vojtapl/esp32-air-quality-monitor-epd/resources/img_graph.jpg

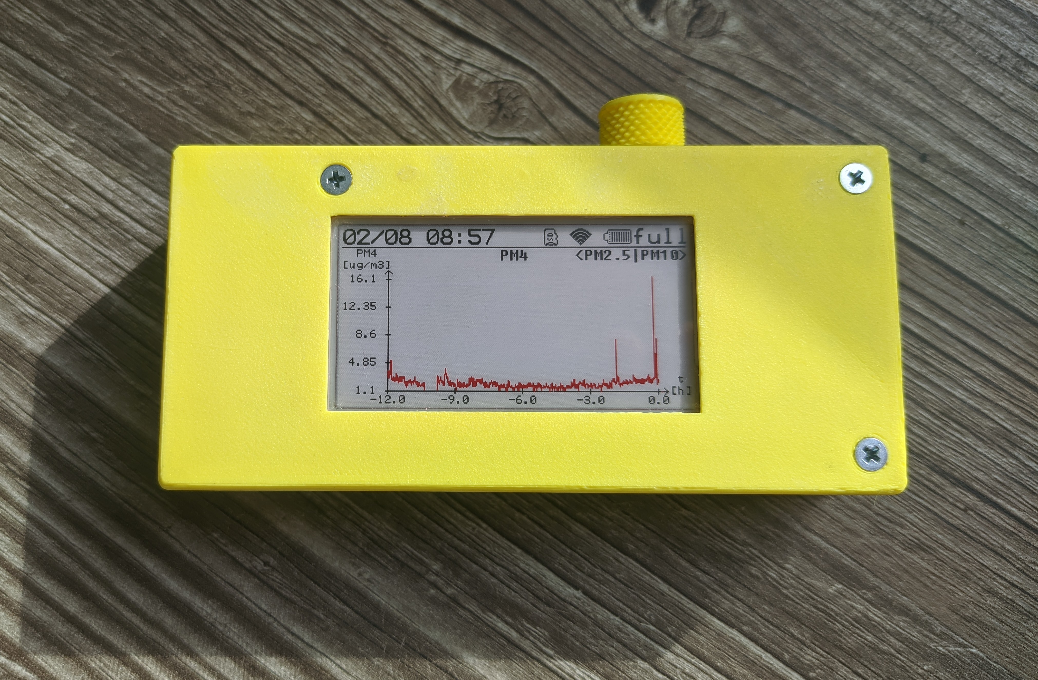
resources/img_graph.jpg
