vojtapl/esp32-air-quality-monitor-epd/hardware/pcb/sen66-air-quality-meter.kicad_pcb

## KiCad design hardware/pcb/sen66-air-quality-meter.kicad_pcb (2025-08-02)

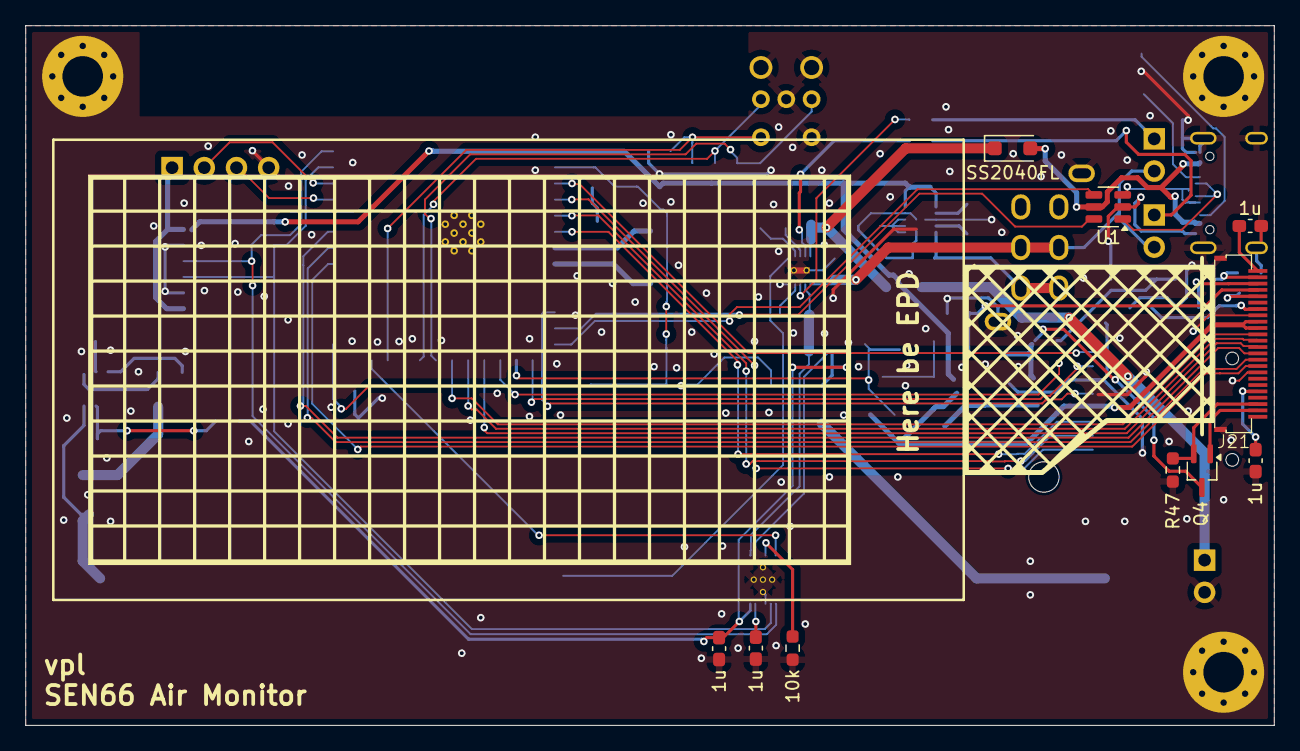
[picture p7: board sen66-air-quality-meter.kicad_pcb from above]

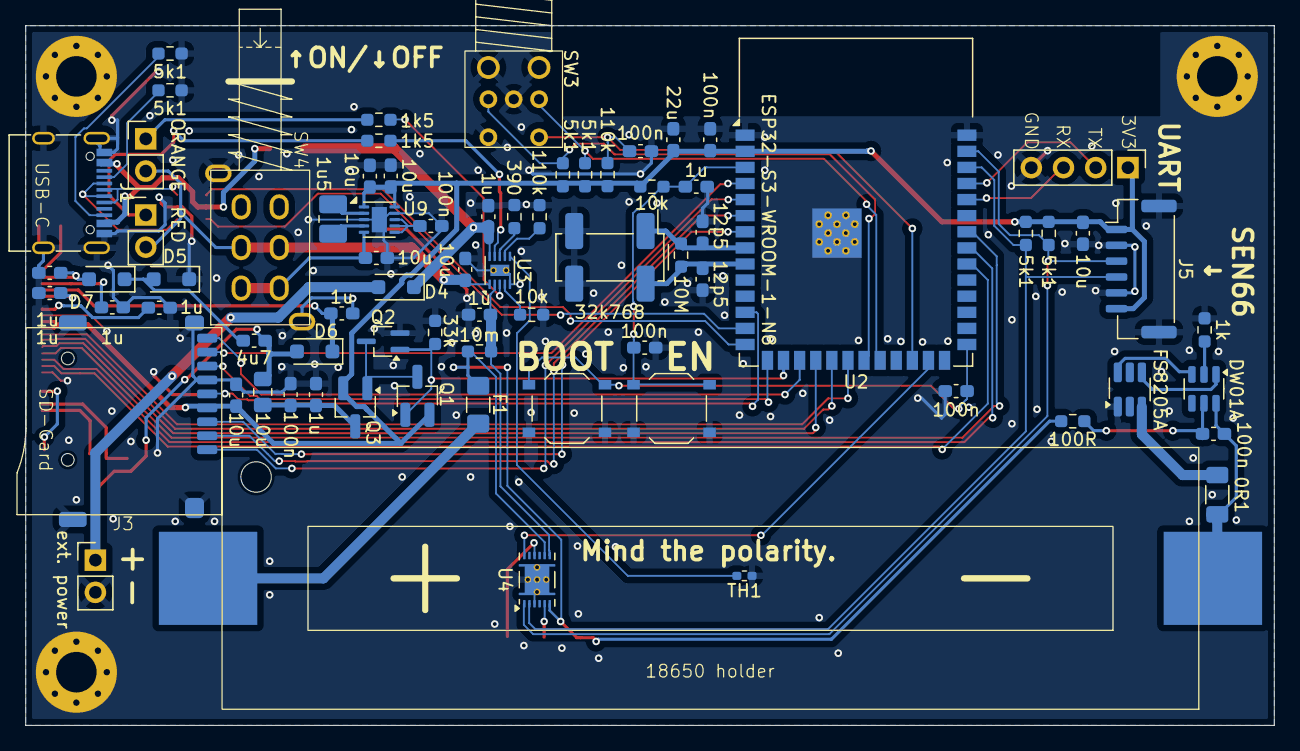
[picture p8: board sen66-air-quality-meter.kicad_pcb from below]

Board: 2 copper layers, 98.5 x 55.2 mm, 88 parts (75 on the bottom side), 74 nets.

Parts:
BT1: 18650 battery holder; BH-18650-B1BA002
C1, C2, C6, C8, C15, C26, C28: 100n; C_0603_1608Metric_Pad1.08x0.95mm_HandSolder
C3, C7, C10, C14, C16, C17, C19, C20, C21, C22, C23, C24, C25: 1u; C_0603_1608Metric_Pad1.08x0.95mm_HandSolder
C4, C5: 12p5; C_0603_1608Metric_Pad1.08x0.95mm_HandSolder
C9: 22u; C_0603_1608Metric_Pad1.08x0.95mm_HandSolder
C11, C12, C13, C27, C29, C30: 10u; C_0603_1608Metric_Pad1.08x0.95mm_HandSolder
C18: 4u7; C_0603_1608Metric_Pad1.08x0.95mm_HandSolder
D1: RED; PinHeader_1x02_P2.54mm_Vertical
D2: ORANGE; PinHeader_1x02_P2.54mm_Vertical
D3, D4, D5, D6, D7: SS2040FL; D_SOD-123F
F1: Polyfuse 2A; Fuse_1206_3216Metric_Pad1.42x1.75mm_HandSolder
H2, H3, H4: MountingHole_Pad; MountingHole_3.2mm_M3_Pad_Via
J1: USB-C female, 16P; USB_C_Receptacle_G-Switch_GT-USB-7010ASV
J2: ext. power; PinHeader_1x02_P2.54mm_Vertical
J3: SHOU HAN TF PUSH
J4: UART; PinHeader_1x04_P2.54mm_Vertical
J5: WAFER-GH1.25-6PLB; JST_GH_BM06B-GHS-TBT_1x06-1MP_P1.25mm_Vertical
J21: FH34SRJ24S; FH34SRJ-24S-0.5SH(50)
L1: 10u; L_0805_2012Metric_Pad1.15x1.40mm_HandSolder
L2: 1u5; L_1008_2520Metric_Pad1.43x2.20mm_HandSolder
Q1, Q3: AP2305; SOT-23_Handsoldering
Q2, Q4: SI1308EDL; SOT-323_SC-70_Handsoldering
R1, R2, R4, R5, R7, R8: 5k1; R_0603_1608Metric_Pad0.98x0.95mm_HandSolder
R3, R9, R16: 10k; R_0603_1608Metric_Pad0.98x0.95mm_HandSolder
R6, R11: 110k; R_0603_1608Metric_Pad0.98x0.95mm_HandSolder
R10: 10M; R_0603_1608Metric_Pad0.98x0.95mm_HandSolder
R12, R13: 1k5; R_0603_1608Metric_Pad0.98x0.95mm_HandSolder
R14: 390; R_0603_1608Metric_Pad0.98x0.95mm_HandSolder
R15: 33k; R_0603_1608Metric_Pad0.98x0.95mm_HandSolder
R17: 10m; R_0603_1608Metric_Pad0.98x0.95mm_HandSolder
R18: 1k; R_0603_1608Metric_Pad0.98x0.95mm_HandSolder
R19: R47; R_0603_1608Metric_Pad0.98x0.95mm_HandSolder
R20: 0R1; R_1206_3216Metric_Pad1.30x1.75mm_HandSolder
R21: 100R; R_0603_1608Metric_Pad0.98x0.95mm_HandSolder
SW1, SW2: TS-1187A; SW_Push_1P1T_XKB_TS-1187A
SW3: ED08905M; ED08905M-FE13C7.3-C10-2053
SW4: XKBS22E05-Z
TH1: NTCG104BH103HT1; R_0402_1005Metric_Pad0.72x0.64mm_HandSolder
U1: USBLC6-2SC6; SOT-23-6
U2: ESP32-S3-WROOM-1-N8; ESP32-S3-WROOM-1
U3: BQ25185; Texas_DLH0010A_WSON-10-1EP_2.2x2mm_P0.4mm_EP0.9x1.5mm_Therm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
U4: BQ27441DRZR-G1A; Texas_S-PDSO-N12
U6: DW01A; SOT-23-6
U7: FS8205A; SOT-23-6_Handsoldering
U9: TPS63031DSK; WSON-10-1EP_2.5x2.5mm_P0.5mm_EP1.2x2mm
Y1: 32k768; Crystal_SMD_SeikoEpson_MC306-4Pin_8.0x3.2mm_HandSoldering

Connections:
+3V3: C8.1, C9.1, C12.1, C13.1, C29.1, C30.1, J3.4 (VDD), J4.1, J5.1, J5.6, J21.15, J21.16, Q1.2 (S), Q3.2 (S), R1.1, R2.1, R3.1, R6.1, R7.1, R8.1, U2.2 (3V3), U9.1 (VOUT), U9.10 (FB)
/BOOT_OPTION: C2.1, SW2.1, U2.27 (IO0)
/BUSY: J21.9, U2.32 (IO39)
/D/C: J21.11, U2.34 (IO41)
/EN: C1.1, C3.2, R3.2, SW1.1, U2.3 (EN)
/EPD_POWER: Q1.1 (G), Q2.1 (G), R15.1, U2.16 (IO46)
/RES: J21.10, U2.33 (IO40)
/RX: J4.3, U2.36 (RXD0)
/SCL: J5.4, R8.2, U2.38 (IO2), U4.2 (SCL)
/SD CLK: J3.5 (CLK), U2.12 (IO8)
/SD CMD: J3.3 (CMD), U2.7 (IO7)
/SD D0: J3.7 (DAT0), U2.15 (IO3)
/SD D1: J3.8 (DAT1), U2.4 (IO4)
/SD D2: J3.1 (DAT2), U2.5 (IO5)
/SD D3: J3.2 (DAT3/CD), U2.6 (IO6)
/SD DET: J3.9 (DET), U2.17 (IO9)
/SDA: J5.3, R7.2, U2.39 (IO1), U4.1 (SDA)
/SPI_MOSI: J21.14, U2.20 (IO12)
/SPI_SCLK: J21.13, U2.19 (IO11)
/TX: J4.2, U2.37 (TXD0)
/USB 5V: D3.2 (A), J1.A4 (VBUS), J1.A9 (VBUS), J1.B4 (VBUS), J1.B9 (VBUS), U1.5 (VBUS)
/USB D+: U1.4 (I/O2), U2.14 (USB_D+)
/USB D-: U1.6 (I/O1), U2.13 (USB_D-)
/V_{BAT}: C10.1, R17.2, U3.2 (BAT), U4.7 (SRN)
/bat low alarm: U2.25 (IO48), U4.12 (GPOUT)
/encoder A: R2.2, SW3.A, U2.21 (IO13)
/encoder B: R1.2, SW3.B, U2.22 (IO14)
/encoder button: C6.2, R6.2, SW3.S1, U2.24 (IO47)
/~SPI_EPD_CS: J21.12, U2.18 (IO10)
GND: C1.2, C2.2, C3.1, C4.2, C5.2, C6.1, C7.2, C8.2, C9.2, C10.2, C11.2, C12.2, C13.2, C14.2, C15.2, C16.2, C17.2, C19.2, C20.2, C21.2, C22.2, C23.2, C24.2, C25.2, C27.2, C28.2, C29.2, C30.2, D5.1 (K), H2.1, H3.1, H4.1, J1.A1 (GND), J1.A12 (GND), J1.B1 (GND), J1.B12 (GND), J1.S1 (SHIELD), J2.2, J3.6 (VSS), J3.10 (SHIELD), J4.4, J5.2, J5.5, J5.MP (MountPin), J21.8, J21.17, J21.MP (MountPin), Q2.2 (S), R4.2, R5.2, R9.1, R11.2, R14.2, R15.2, R16.1, R18.2, R19.2, SW1.2, SW2.2, SW3.C, SW3.MP, SW3.S2, SW4.MP, TH1.1, U1.2 (GND), U2.1 (GND), U2.40 (GND), U2.41 (GND), U3.5 (GND), U3.11 (Thermal_Pad), U4.3 (V_{SS}), U4.13 (PAD), U7.1 (S1), U9.3 (PGND), U9.9 (GND), U9.11 (PGND), Y1.2, Y1.3
unnamed: BT1.1 (+), F1.2
unnamed: BT1.2 (-), C26.2, R20.2, U6.6 (GND)
unnamed: D1.1 (K), R12.1
unnamed: D2.1 (K), R13.1
unnamed: C7.1, D3.1 (K), D4.1 (K), U3.10 (IN)
unnamed: D4.2 (A), J2.1
unnamed: C18.2, D5.2 (A), D7.1 (K)
unnamed: C18.1, D6.2 (A), L1.2, Q4.3 (D)
unnamed: C19.1, D6.1 (K), J21.21
unnamed: C20.1, D7.2 (A), J21.23
unnamed: J1.A5 (CC1), R4.1
unnamed: J1.B5 (CC2), R5.1
unnamed: J1.A6 (D+), J1.B6 (D+), U1.3 (I/O2)
unnamed: J1.A7 (D-), J1.B7 (D-), U1.1 (I/O1)
unnamed: J21.2, Q4.1 (G)
unnamed: J21.3, Q4.2 (S), R19.1
unnamed: C21.1, J21.5
unnamed: C22.1, J21.18
unnamed: C23.1, J21.20
unnamed: C24.1, J21.22
unnamed: C25.1, J21.24
unnamed: Q1.3 (D), Q2.3 (D), Q3.1 (G)
unnamed: C15.1, C16.1, L1.1, Q3.3 (D)
unnamed: C4.1, R10.1, U2.8 (IO15), Y1.1
unnamed: C5.1, R10.2, U2.9 (IO16), Y1.4
unnamed: R11.1, U3.7 (ILIM/VSET)
unnamed: R14.1, U3.8 (I_{SET})
unnamed: R12.2, U3.9 (STAT1)
unnamed: R13.2, U3.3 (STAT2)
unnamed: TH1.2, U3.6 (TS/MR)
unnamed: R9.2, U3.4 (~CE)
unnamed: C17.1, F1.1, R17.1, R21.1, U4.6 (BAT), U4.8 (SRP)
unnamed: R16.2, U4.10 (BIN)
unnamed: C14.1, U4.5 (V_{DD})
unnamed: R18.1, U6.2 (CS)
unnamed: U6.3 (OC), U7.6 (G1)
unnamed: U6.1 (OD), U7.4 (G2)
unnamed: C26.1, R21.2, U6.5 (VCC)
unnamed: R20.1, U7.3 (S2)
unnamed: C28.1, U9.6 (EN), U9.7 (PS/SYNC), U9.8 (VINA)
unnamed: L2.2, U9.4 (L1)
unnamed: L2.1, U9.2 (L2)
unnamed: C27.1, SW4.3, SW4.6, U9.5 (VIN)
VBUS: C11.1, D1.2 (A), D2.2 (A), SW4.2, SW4.5, U3.1 (SYS)
