vojtapl/esp32-air-quality-monitor-epd/software/esp32/src/config.h

#pragma once

#define SERIAL_BAUDRATE 460800
#define I2C_CLOCK 100000

#define DATA_PATH "/data.csv"

#define BUF_SIZE 128 // measured once at 103 chars

#define BATTERY_INIT_CAPACITY_mAh 2000
#define BATTERY_NOMINAL_VOLTAGE_V 3.7f
#define BATTERY_TERMINAL_VOLTAGE_mV 3000 // TODO: check the value
#define BATTERY_TAPER_CURRENT_mA 81      // 10% of I_charge

#define BTN_PRESS_THRESHOLD_SHORT 50  // in ms
#define BTN_PRESS_THRESHOLD_LONG 1000 // in ms

#define UPDATE_PERIOD_EPD 300  // in s
#define UPDATE_PERIOD_SEN66 10 // in s

#ifdef NO_ERROR
#undef NO_ERROR
#endif
#define NO_ERROR 0

#define LONG_PRESS 2000

#define THRESH_BADNESS_1_PM1 35
#define THRESH_BADNESS_2_PM1 55

#define THRESH_BADNESS_1_PM2P5 35
#define THRESH_BADNESS_2_PM2P5 55

#define THRESH_BADNESS_1_PM4 35
#define THRESH_BADNESS_2_PM4 55

#define THRESH_BADNESS_1_PM10 155
#define THRESH_BADNESS_2_PM10 255

#define THRESH_BADNESS_1_HUMIDEX 32
#define THRESH_BADNESS_2_HUMIDEX 36

#define THRESH_BADNESS_1_VOC 100
#define THRESH_BADNESS_2_VOC 200

#define THRESH_BADNESS_1_NOX 100
#define THRESH_BADNESS_2_NOX 200

#define THRESH_BADNESS_1_CO2 1000
#define THRESH_BADNESS_2_CO2 1500

#define RANGE_MAX_PM 1000
#define RANGE_MAX_RH 100
#define RANGE_MAX_T 100
#define RANGE_MAX_INDEX 500
#define RANGE_MAX_CO2 40000
