vojtapl/esp32-air-quality-monitor-epd/software/esp32/src/graphics.h

#include <cstdint>

const uint8_t image_battery_0[] = {
    0x00, 0x00, 0x00, 0xf0, 0xff, 0x7f, 0x08, 0x00, 0x80, 0x08, 0x02, 0x82,
    0x0e, 0x04, 0x81, 0x01, 0x88, 0x80, 0x01, 0x50, 0x80, 0x01, 0x20, 0x80,
    0x01, 0x50, 0x80, 0x01, 0x88, 0x80, 0x0e, 0x04, 0x81, 0x08, 0x02, 0x82,
    0x08, 0x00, 0x80, 0xf0, 0xff, 0x7f, 0x00, 0x00, 0x00, 0x00, 0x00, 0x00};
const uint8_t image_battery_10[] = {
    0x00, 0x00, 0x00, 0xf0, 0xff, 0x7f, 0x08, 0x00, 0x80, 0x08, 0x00, 0xa0,
    0x0e, 0x00, 0xa0, 0x01, 0x00, 0xa0, 0x01, 0x00, 0xa0, 0x01, 0x00, 0xa0,
    0x01, 0x00, 0xa0, 0x01, 0x00, 0xa0, 0x0e, 0x00, 0xa0, 0x08, 0x00, 0xa0,
    0x08, 0x00, 0x80, 0xf0, 0xff, 0x7f, 0x00, 0x00, 0x00, 0x00, 0x00, 0x00};
const uint8_t image_battery_20[] = {
    0x00, 0x00, 0x00, 0xf0, 0xff, 0x7f, 0x08, 0x00, 0x80, 0x08, 0x00, 0xa8,
    0x0e, 0x00, 0xa8, 0x01, 0x00, 0xa8, 0x01, 0x00, 0xa8, 0x01, 0x00, 0xa8,
    0x01, 0x00, 0xa8, 0x01, 0x00, 0xa8, 0x0e, 0x00, 0xa8, 0x08, 0x00, 0xa8,
    0x08, 0x00, 0x80, 0xf0, 0xff, 0x7f, 0x00, 0x00, 0x00, 0x00, 0x00, 0x00};
const uint8_t image_battery_30[] = {
    0x00, 0x00, 0x00, 0xf0, 0xff, 0x7f, 0x08, 0x00, 0x80, 0x08, 0x00, 0xaa,
    0x0e, 0x00, 0xaa, 0x01, 0x00, 0xaa, 0x01, 0x00, 0xaa, 0x01, 0x00, 0xaa,
    0x01, 0x00, 0xaa, 0x01, 0x00, 0xaa, 0x0e, 0x00, 0xaa, 0x08, 0x00, 0xaa,
    0x08, 0x00, 0x80, 0xf0, 0xff, 0x7f, 0x00, 0x00, 0x00, 0x00, 0x00, 0x00};
const uint8_t image_battery_40[] = {
    0x00, 0x00, 0x00, 0xf0, 0xff, 0x7f, 0x08, 0x00, 0x80, 0x08, 0x80, 0xaa,
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
const uint8_t image_micro_sd_no_card[] = {
    0xfc, 0x03, 0x05, 0x04, 0x02, 0x04, 0x06, 0x04, 0xca, 0x0c, 0x12,
    0x09, 0x32, 0x11, 0x42, 0x10, 0x92, 0x08, 0x52, 0x09, 0x22, 0x13,
    0x02, 0x14, 0xe2, 0x09, 0x1a, 0x16, 0xec, 0x2b, 0x00, 0x00};
