vojtapl/esp32-air-quality-monitor-epd/(commit log)

2025-08-02 Initial commit.
    [sen66-air-quality-meter.kicad_pcb, sen66-air-quality-meter.kicad_sch]
2025-08-05 update acknowledgements, added some assembly info
2025-08-05 graph - add seeking to relevant part; fix typo
    [draw.h]
